fre69/bateau-rc/apercu_catamaran.png

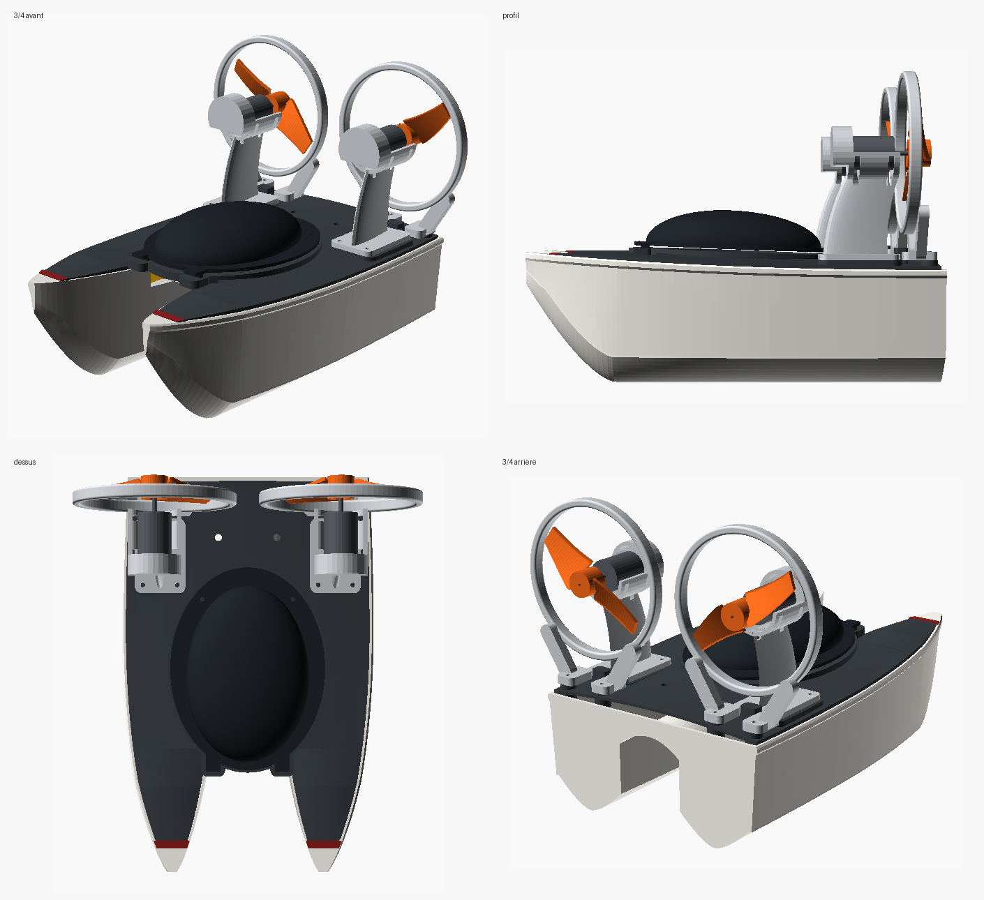
apercu_catamaran.png
