fre69/bateau-rc/stl/07_anneau_protection_D95_x2.stl

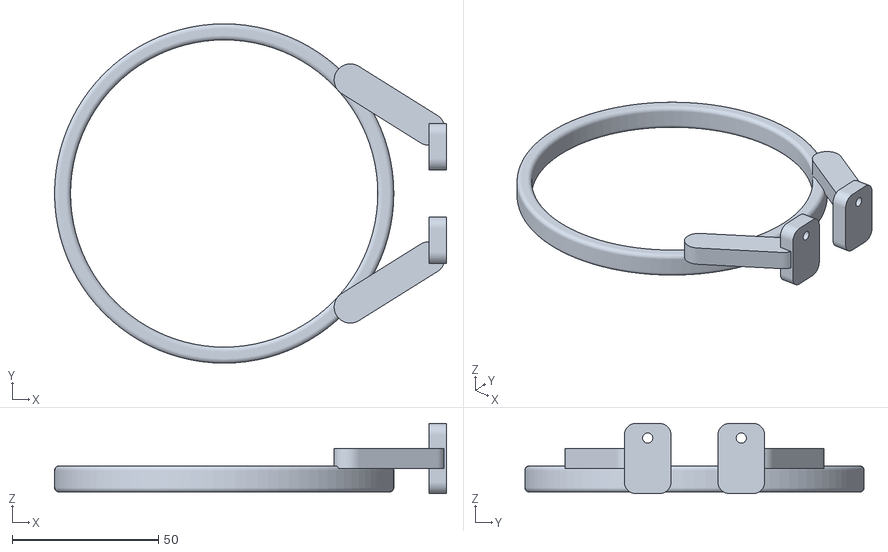
[picture p2: CAD file, 2026-07-20]
stl/07_anneau_protection_D95_x2.stl
134.0 x 116.0 x 24.0
