fre69/bateau-rc/stl/08_helice_D95_cal30-15_pignon7_CCW.stl

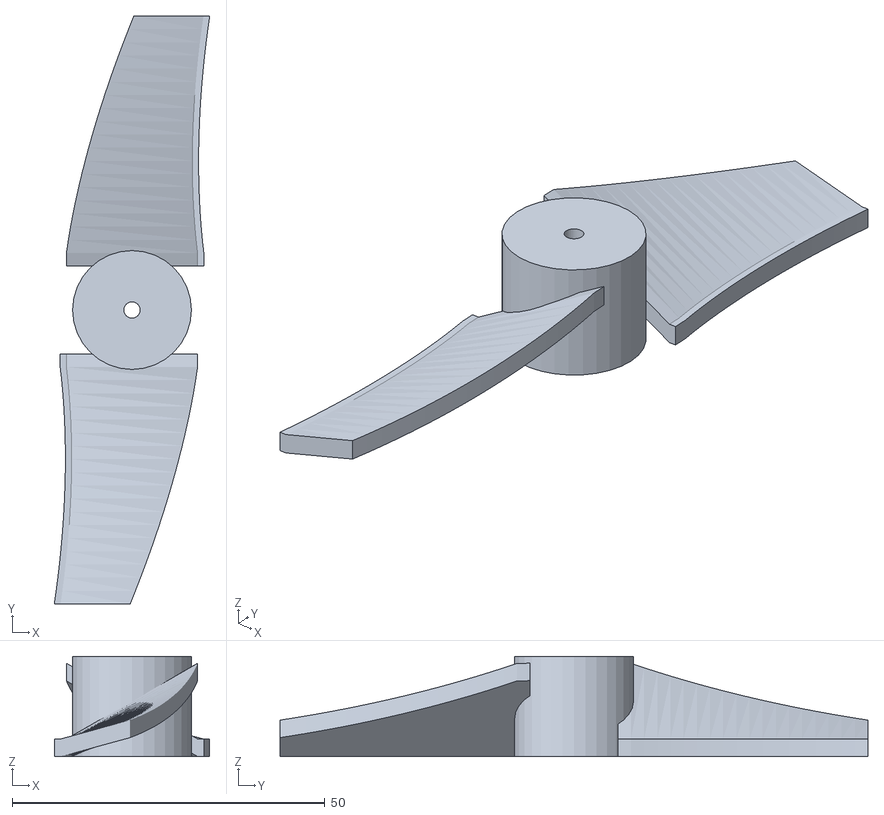
[picture p3: CAD file, 2026-07-20]
stl/08_helice_D95_cal30-15_pignon7_CCW.stl
24.9 x 94.0 x 16.0
