fre69/bateau-rc/stl/13_cloison_avant.stl

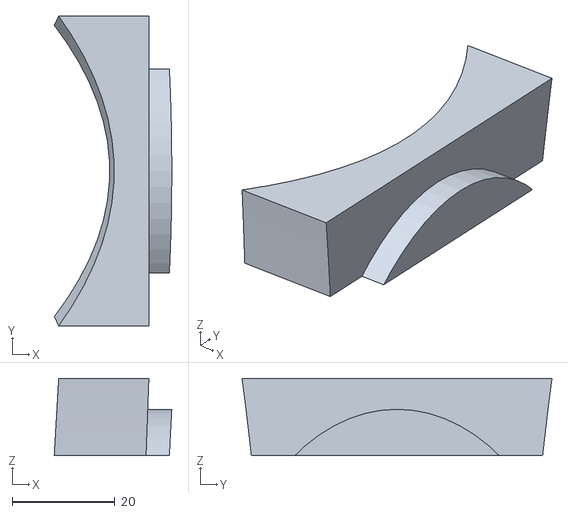
[picture p4: CAD file, 2026-07-17]
stl/13_cloison_avant.stl
22.8 x 60.2 x 15.0
