fre69/bateau-rc/stl/11_bouchon_etrave_x2.stl

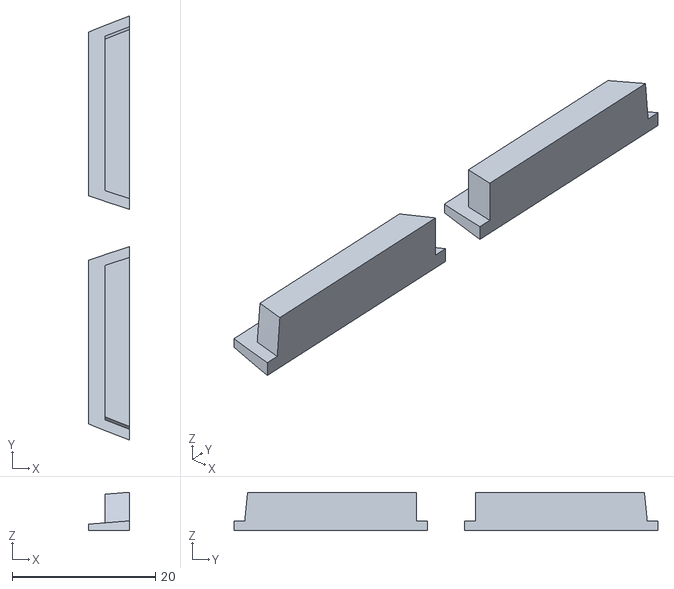
[picture p5: CAD file, 2026-07-17]
stl/11_bouchon_etrave_x2.stl
5.70 x 59.2 x 5.38
