fre69/bateau-rc/stl/05_pylone_moteur_x2.stl

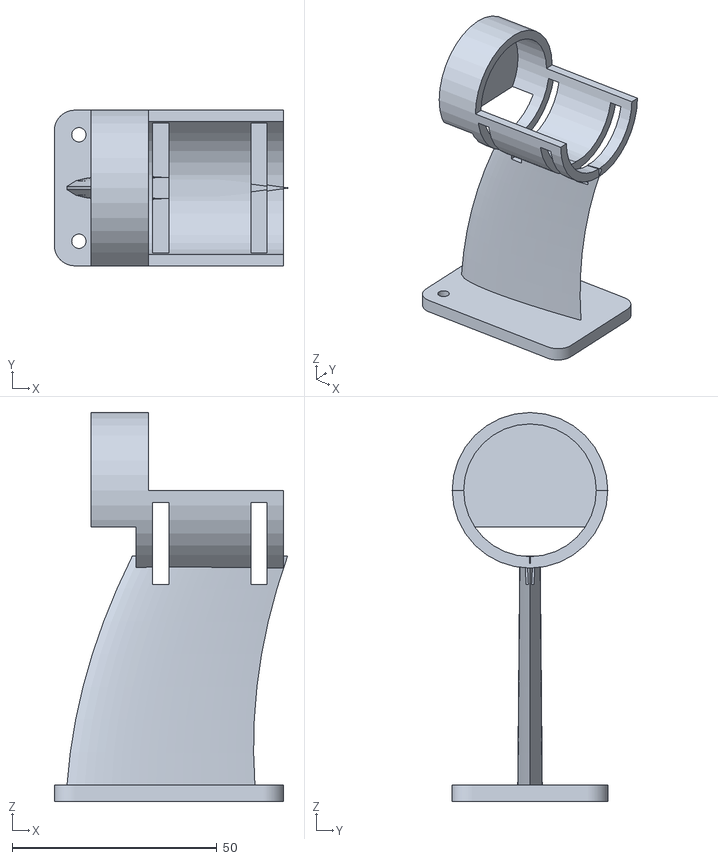
[picture p6: CAD file, 2026-07-15]
stl/05_pylone_moteur_x2.stl
57.0 x 38.0 x 95.0
