fre69/bateau-rc/stl/02_pont.stl

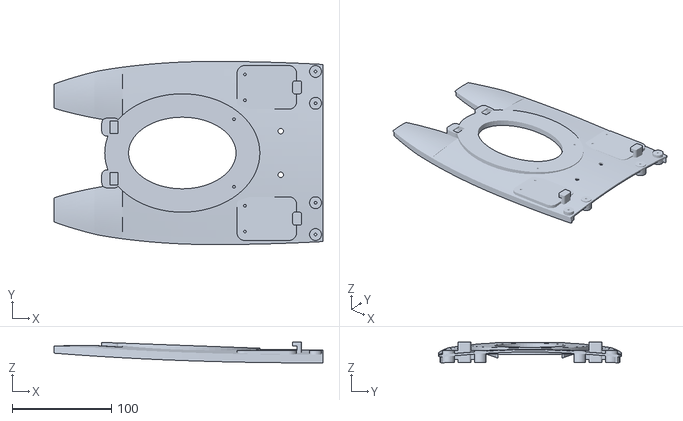
[picture p7: CAD file, 2026-07-14]
stl/02_pont.stl
270.5 x 184.2 x 21.0
