fre69/bateau-rc/stl/01_coque.stl

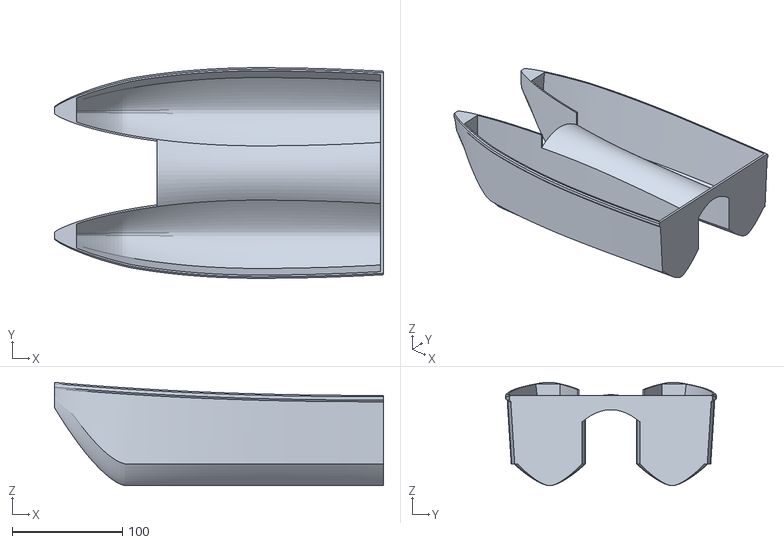
[picture p8: CAD file, 2026-07-14]
stl/01_coque.stl
298.0 x 190.8 x 93.6
