fre69/bateau-rc/stl/04_joint_capot_TPU.stl

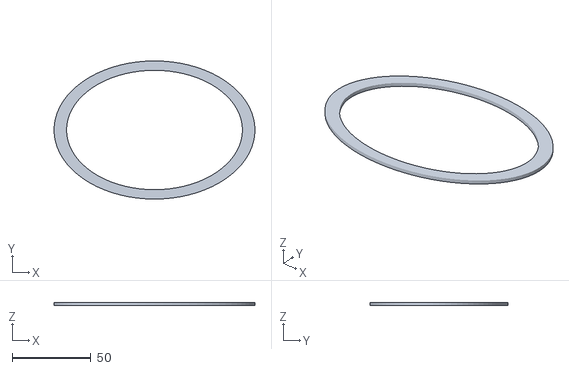
[picture p9: CAD file, 2026-07-14]
stl/04_joint_capot_TPU.stl
128.0 x 88.0 x 2.00
