fre69/bateau-rc/stl/03_capot.stl

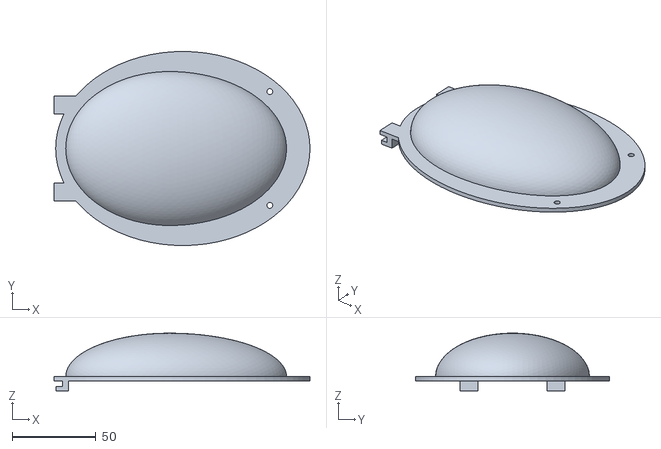
[picture p10: CAD file, 2026-07-14]
stl/03_capot.stl
153.0 x 116.0 x 34.5
