fre69/bateau-rc/stl/10_bouton_capot_x2.stl

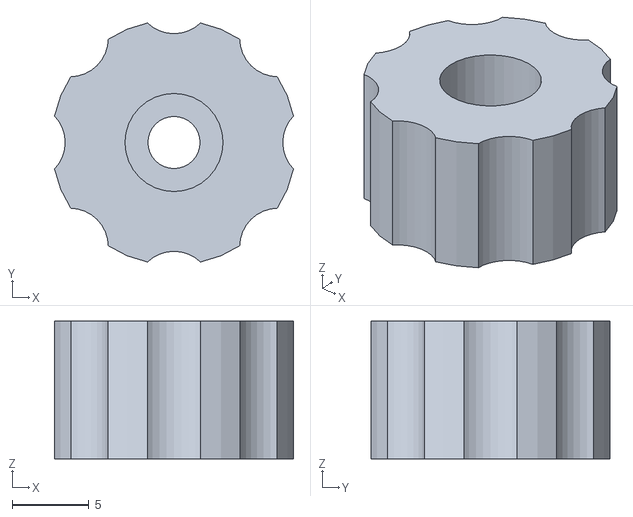
[picture p11: CAD file, 2026-07-14]
stl/10_bouton_capot_x2.stl
15.6 x 15.6 x 9.00
