fre69/bateau-rc/stl/09_pile_factice_AA.stl

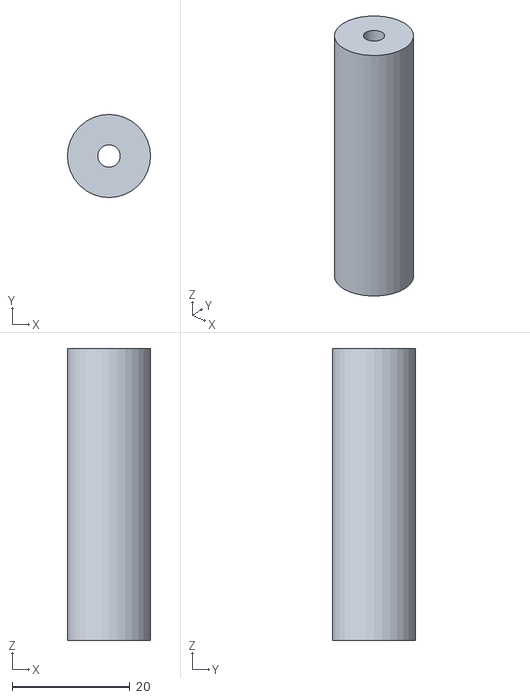
[picture p12: CAD file, 2026-07-14]
stl/09_pile_factice_AA.stl
14.1 x 14.1 x 49.5
