fre69/bateau-rc/stl/06_bague_moteur_24_0mm.stl

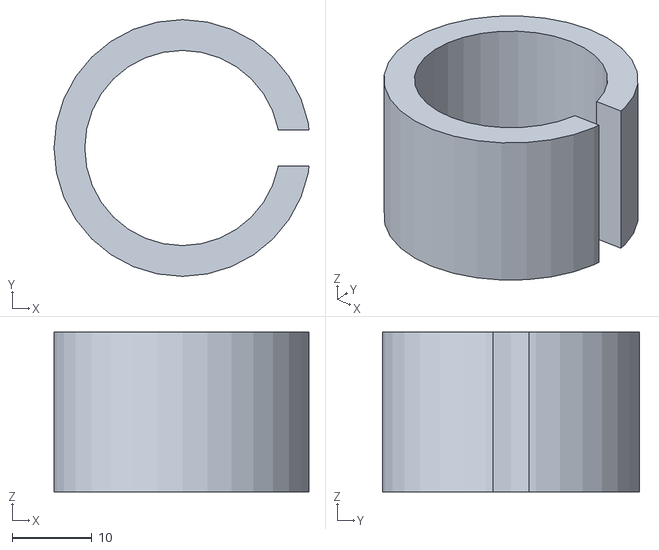
[picture p13: CAD file, 2026-07-14]
stl/06_bague_moteur_24_0mm.stl
31.9 x 32.1 x 20.0
