fre69/bateau-rc/(list of files, cad)

Other CAD files:
stl/08_helice_D95_cal30-15_pignon7_CW.stl
