fre69/bateau-rc/(commit log)

2026-07-14 Catamaran RC a helices aeriennes v2 - generateur parametrique complet
    Refonte totale du design (recup Nikko N-Blaster, pilotage differentiel) :
    etraves inclinees, tonture classique, spray-rails, capsule cockpit sur
    plinthe inclinee (acces piles sans outil : languettes + boutons moletes),
    pylones profiles a griffe, anneaux-conduits. 24 STL, rendus OpenSCAD,
    hydrostatique et controle de collisions d'assemblage integres au script.
    [01_coque.stl, 02_pont.stl, 03_capot.stl, 04_joint_capot_TPU.stl, 05_pylone_moteur_x2.stl, 06_bague_moteur_24_0mm.stl, 06_bague_moteur_27_7mm.stl, 06_bague_moteur_30_0mm.stl]
2026-07-14 Bouchons de loft par earcut : supprime les parois trouees aux extremites
    L'eventail centroide fermant les lofts s'auto-intersectait sur les sections
    concaves (tunnel, raise_top, levre du pont) ; manifold3d ressortait une paroi
    dechiquetee <0.5 mm sur la derniere travee -> trous au slicing a l'arriere
    (x=297.4), a XJ et aux pointes d'etraves. Bouchons tries par mapbox_earcut,
    orientes par aire signee, plan de section auto-detecte. STL regeneres,
    0 zone fine sur la coque (40 avant). Piege n.14 documente dans CLAUDE.md.
    [01_coque.stl, 02_pont.stl, 03_capot.stl, 04_joint_capot_TPU.stl, 05_pylone_moteur_x2.stl, 07_anneau_protection_D100_x2.stl, 07_anneau_protection_D90_x2.stl, 08_helice_D100_alesage2_0_CCW.stl]
2026-07-15 Accouplement helice sur pignon conserve + coiffe deparasitage moteur
    - Helices: alesages lisses (2.0/2.3/3.17) remplaces par un moyeu unique
    broche-a-froid sur le pignon 7 mm conserve (alesage 6.4 mm, lead-in + pilote).
    12 STL -> 4 (D100/D90 x CW/CCW, "pignon7").
    - Pylone: coiffe arriere-moteur integree (ogive fermee avant, ouverte dessous)
    qui cache et protege le deparasitage (2 selfs + condo). Dimensionnee 35 mm.
    - Bague moteur: reduite a la seule taille 24 mm (moteur mesure 24x30 mm).
    - D90 conserve comme option 7.2 V (helice + anneau).
    - Docs MONTAGE.md et CLAUDE.md mis a jour; assemblage/planche 4 vues regeneres.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
    [05_pylone_moteur_x2.stl, 06_bague_moteur_27_7mm.stl, 06_bague_moteur_30_0mm.stl, 08_helice_D100_alesage2_0_CCW.stl, 08_helice_D100_alesage2_0_CW.stl, 08_helice_D100_alesage2_3_CCW.stl, 08_helice_D100_alesage2_3_CW.stl, 08_helice_D100_alesage3_17_CCW.stl]
2026-07-17 Etancheite : cloison avant, bouchons d'etrave, et le compartiment central n'existait pas
    Trois defauts de conception trouves a l'emboitement a blanc, tous invisibles aux controles
    automatiques : chaque piece est manifold, et un MANQUE n'est pas une collision.
    - Piege 18 : a XJ=95, l'enveloppe ET la cavite demarrent au meme x -> aucune cloison sur la
    face avant du pont-bras. Le compartiment etait ouvert plein nez sur 7.9 cm2, oriente vers
    l'avant. Ferme par 13_cloison_avant : booleen sur la cavite, largeur qui suit yi_cav(x),
    et SOUSTRACTION du pont -- l'intrados est bombe (sheer + crown, +5 dans l'axe), une piece
    butee sur sheer laissait 5 mm de jour.
    - Piege 16 : la cuve s'ouvre a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
    [08_helice_D100_pignon7_CCW.stl, 08_helice_D100_pignon7_CW.stl, 08_helice_D90_pignon7_CCW.stl, 08_helice_D90_pignon7_CW.stl, 11_bouchon_etrave_x2.stl, 13_cloison_avant.stl, apercu_assemblage.scad]
2026-07-17 Helices : pale fine posee sur le bord de fuite (imprimable proprement)
    Refonte du profil d'helice apres essais d'impression rates :
    - corrige le calage (sin/cos inverses -> pas reel de 1310 mm au lieu de 72)
    - abandonne la lentille a bords en lame (epaisseur nulle -> trous, cordons)
    - pale fine (blade_ramp_sec, ~2,4 mm) posee sur son bord de fuite : seule
    l'arete touche le plateau, montee en rampe a 30 deg (PROP_ALPHA). Support
    court sous la pale seulement, bords francs qui ne dechirent pas.
    - paires helices/anneaux et helices/pylones ajoutees au tableau collisions
    - supprime le .3mf tranche sur l'ancienne geometrie
    - doc : MONTAGE.md piece 08 + section 4, CLAUDE.md piege n.19
    Co-Author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
    [08_helice_D100_pignon7_CCW.3mf, 08_helice_D100_pignon7_CCW.stl, 08_helice_D100_pignon7_CW.stl, 08_helice_D90_pignon7_CCW.stl, 08_helice_D90_pignon7_CW.stl]
2026-07-20 Helices : bipale D95 vrillee 30->15 deg, conso ancree sur les mesures
    Le D100 tripale a calage CONSTANT tirait 3 A par moteur et mettait la
    carte RC en securite : pas/D de 1.36, deux a trois fois ce qu'encaisse
    un moteur de jouet en 6 V.
    - Calage VRILLE 30 deg emplanture -> 15 deg bout. Le couple est pondere
    en r^3 : c'est le bout qui coute, l'emplanture garde ses 30 deg (corde
    large, la rampe d'impression doit y rester franche). Pas/D -> 0.84, et
    la rampe au bout tombe de 6.4 a 3.1 mm, donc support plus COURT.
    - 2 PALES au lieu de 3 : a courant egal, une bipale a 15 deg pousse plus
    qu'une tripale a 10 deg. Meilleur levier du lot, jamais teste avant
    parce que range(3) etait code e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
    [07_anneau_protection_D100_x2.stl, 07_anneau_protection_D90_x2.stl, 07_anneau_protection_D95_x2.stl, 08_helice_D100_pignon7_CCW.stl, 08_helice_D100_pignon7_CW.stl, 08_helice_D90_pignon7_CCW.stl, 08_helice_D90_pignon7_CW.stl, 08_helice_D95_cal30-15_pignon7_CCW.stl]
